FyraLabs/suzyqboard/README.md

# SuzyQ Board


This project is an implementation of the SuzyQ used to access [CCD](https://chromium.googlesource.com/chromiumos/third_party/hdctools/+/main/docs/ccd.md) on Chromebooks.
Using CCD, you can (un)brick, debug, and flash (ex. coreboot) your Chromebook.

## Purchase

You can purchase a SuzyQ Board on the [Fyra Shop](https://shop.fyralabs.com/products/suzyq-board).

## Usage

Check out our [devdocs](https://developer.fyralabs.com/suzyqboard) for usage information.

## Images

Front
Back
