FyraLabs/suzyqboard/case/improved-case.stl

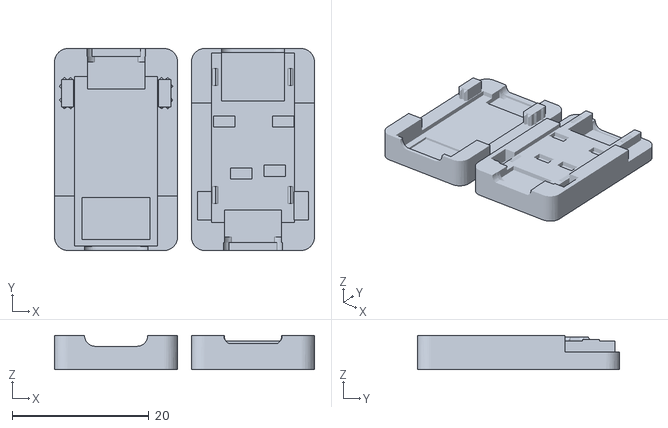
[picture p1: CAD file, 2026-11-14]
case/improved-case.stl
38.0 x 29.5 x 5.00
