FyraLabs/suzyqboard/case/fyralogo-suptract-to-emboss.stl

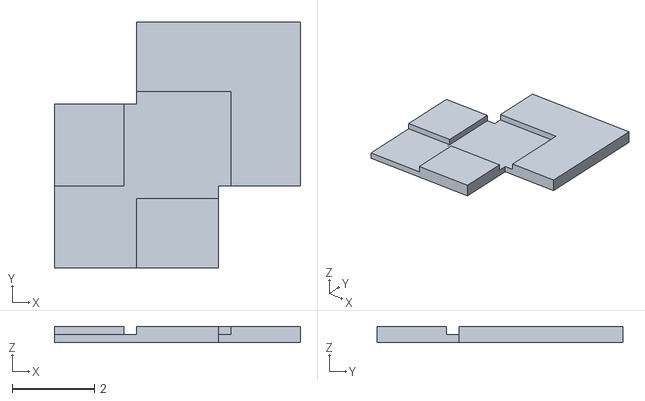
[picture p2: CAD file, 2026-11-14]
case/fyralogo-suptract-to-emboss.stl
6.00 x 6.00 x 0.4
