FyraLabs/suzyqboard/case/11x6 SuzyQ Redesigned.stl

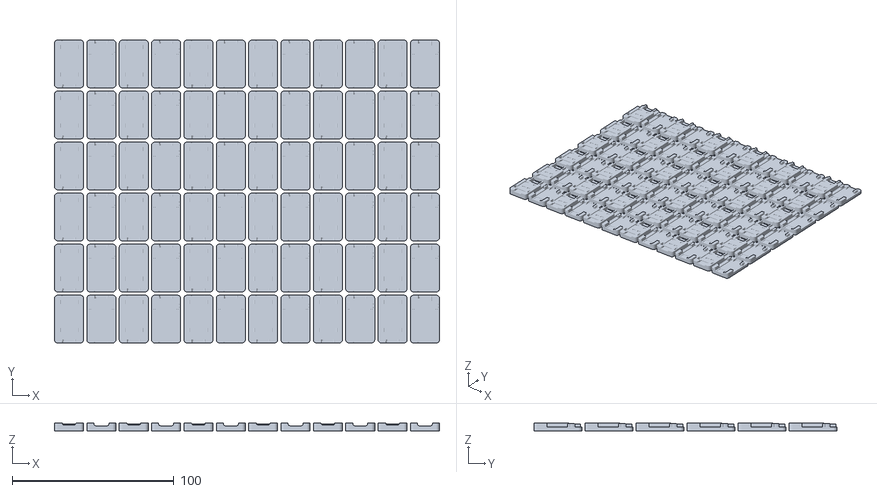
[picture p3: CAD file, 2026-11-14]
case/11x6 SuzyQ Redesigned.stl
238.0 x 187.2 x 5.00
