FyraLabs/suzyqboard/case/case-top.stl

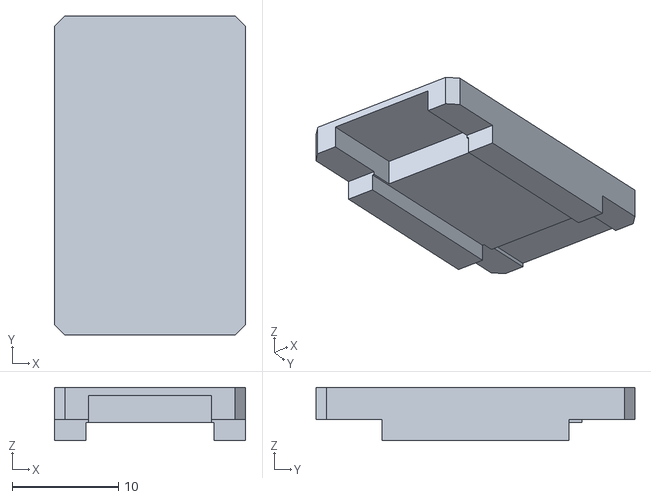
[picture p4: CAD file, 2026-05-01]
case/case-top.stl
18.0 x 30.0 x 5.00
