FyraLabs/suzyqboard/case/case-bottom.stl

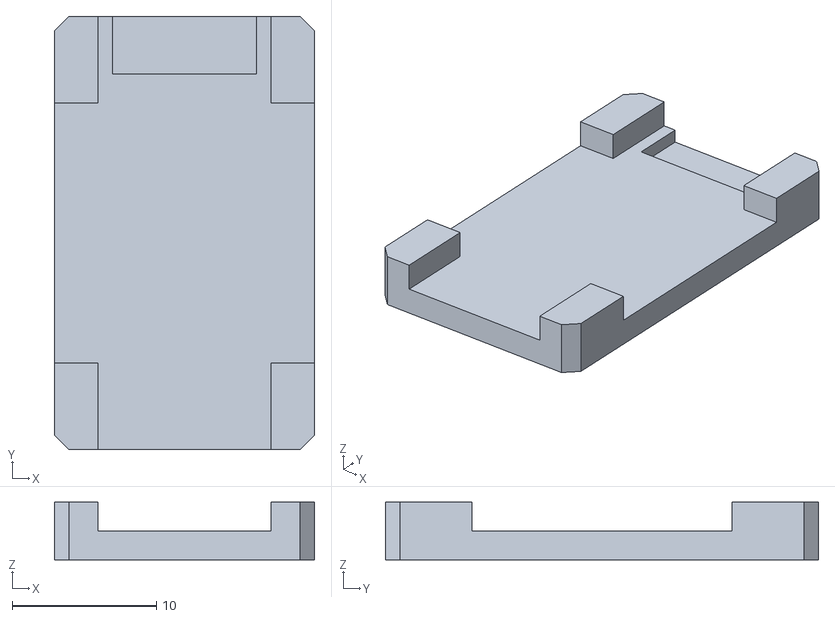
[picture p5: CAD file, 2026-05-01]
case/case-bottom.stl
18.0 x 30.0 x 4.00
