FyraLabs/suzyqboard/(list of files, cad)

Other CAD files:
case/case-redesign.stl
case/SuzyQ Redesigned.stl
