FyraLabs/suzyqboard/(commit log)

2024-01-27 feat: initial commit
    [suzyqboard.kicad_pcb, suzyqboard.kicad_sch]
2024-01-27 fix: add receptacle label
    [suzyqboard.kicad_sch]
2024-01-27 fix: add pulldown resistors from host to GND
    [suzyqboard.kicad_sch]
2024-01-27 fix: connect d- and d+ pins
    [suzyqboard.kicad_sch]
2024-01-27 feat: add footprints
    [suzyqboard.kicad_sch]
2024-01-27 feat: start PCB layout
    [suzyqboard.kicad_pcb]
2024-01-27 feat: more routing ww
    [suzyqboard.kicad_pcb]
2024-01-27 feat: everything is connected!
    [suzyqboard.kicad_pcb]
2024-01-27 feat: outline
    [suzyqboard.kicad_pcb, suzyqboard.kicad_sch]
2024-01-27 feat: optimize cost
    [suzyqboard.kicad_pcb]
2024-01-28 feat: cleanup
    [suzyqboard.kicad_pcb, suzyqboard.kicad_sch]
2024-01-28 feat; compress
    [suzyqboard.kicad_pcb]
2024-01-28 feat: rereoute some traces
    [suzyqboard.kicad_pcb]
2024-01-28 feat: tweaks
    [suzyqboard.kicad_pcb]
2024-01-30 chore: cleanup
    [suzyqboard.kicad_pcb]
2024-01-30 feat: tune & branding
    [suzyqboard.kicad_pcb]
2024-01-30 feat: tune
    [suzyqboard.kicad_pcb]
2024-01-30 fix: align
    [suzyqboard.kicad_pcb]
2024-02-12 feat: add mfr and lcsc part numbers
    [suzyqboard.kicad_sch]
2024-02-25 feat: update to KiCad 8
    [suzyqboard.kicad_pcb, suzyqboard.kicad_sch]
2024-03-12 feat: larger resistors to not put owen in pain
    [suzyqboard.kicad_pcb, suzyqboard.kicad_sch]
2024-03-12 feat: add side indicators
    [suzyqboard.kicad_pcb]
2024-03-12 Revert "feat: add side indicators"
    This reverts commit 5552813199983ca52796d3e0d278e4bf3d0f7e9b.
    [suzyqboard.kicad_pcb]
2024-03-12 feat: labels fr
    [suzyqboard.kicad_pcb]
2024-07-18 fix: all
    [suzyqboard.kicad_pcb]
2024-07-18 fix: exclude logo
    [suzyqboard.kicad_pcb]
2024-07-18 fix: include LCSC in BOM
    [suzyqboard.kicad_sch]
2024-07-28 change pull-up resistors
    [suzyqboard.kicad_pcb, suzyqboard.kicad_sch]
2024-08-09 fix: fixup for jlcpcb
    [suzyqboard.kicad_pcb, suzyqboard.kicad_sch]
2024-12-30 fix: update LCSC nums
    [suzyqboard.kicad_pcb, suzyqboard.kicad_sch]
2025-10-30 fix: update resistor values
    [suzyqboard.kicad_pcb, suzyqboard.kicad_sch]
2025-12-05 feat: case model
    [case.FCStd]
2025-12-13 feat: new case model
    [case.FCStd]
2025-12-15 add interactive schematic preview badge
2025-12-15 add interactive schematic preview badge
    Added a badge link to PCBHub in the README.
2026-01-08 chore: better case file name
2026-05-01 chore: add case folder, add case stl files
    [case-bottom.stl, case-top.stl]
2026-11-08 Change project badge link to KiCanvas
    Updated badge link from obsolete PCBHub to KiCanvas.
2026-11-14 rm: old case design bulk print
2026-11-14 organize old case files
